vixhvajit/ster-vis-amr/sim/worlds/textures/floor.png

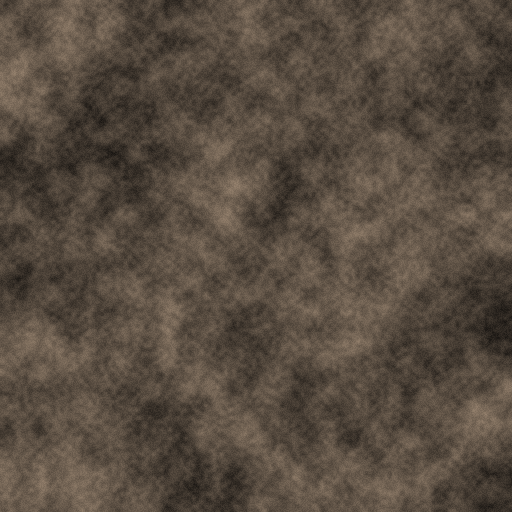
sim/worlds/textures/floor.png
