vixhvajit/ster-vis-amr/sim/worlds/textures/target_green.png

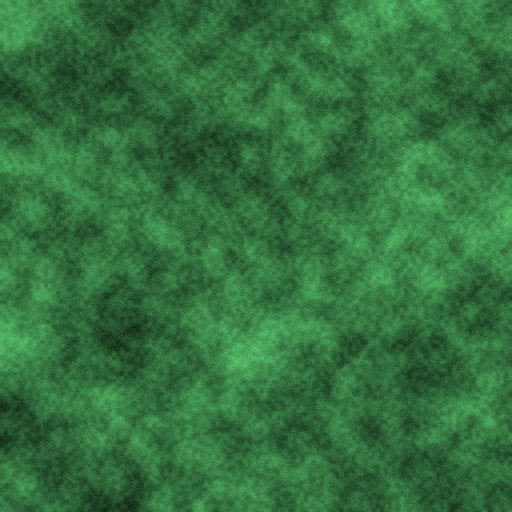
sim/worlds/textures/target_green.png
