vixhvajit/ster-vis-amr/sim/worlds/textures/target_red.png

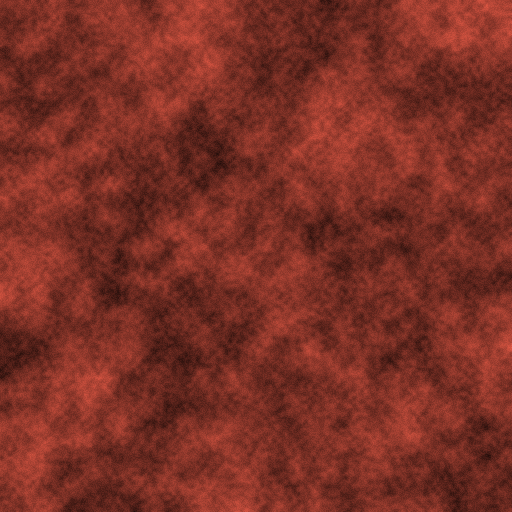
sim/worlds/textures/target_red.png
