vixhvajit/ster-vis-amr/sim/worlds/textures/target_yellow.png

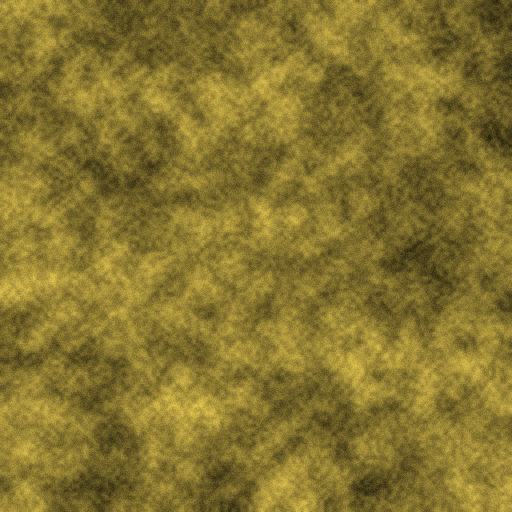
sim/worlds/textures/target_yellow.png
