vixhvajit/ster-vis-amr/sim/worlds/textures/wall.png

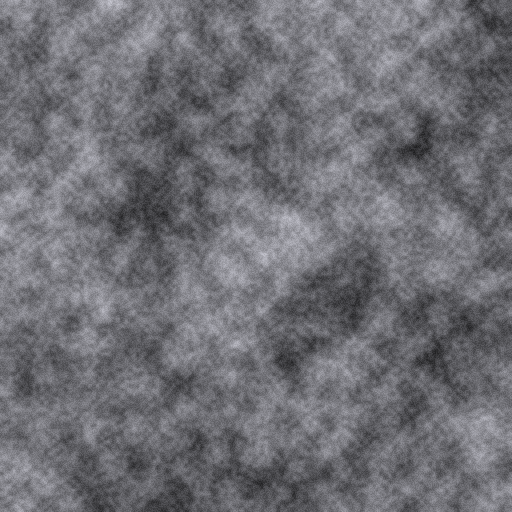
sim/worlds/textures/wall.png
