vixhvajit/ster-vis-amr/sim/models/ster_vis_test_amr/meshes/camera_clamps.stl

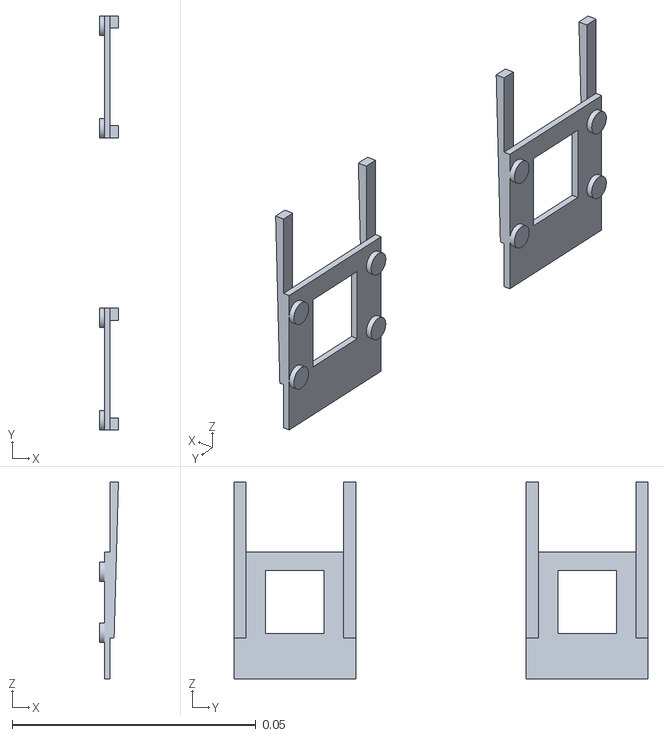
[picture p8: CAD file, 2026-09-25]
sim/models/ster_vis_test_amr/meshes/camera_clamps.stl
0.00389 x 0.085 x 0.0404
