vixhvajit/ster-vis-amr/sim/models/ster_vis_test_amr/meshes/deck.stl

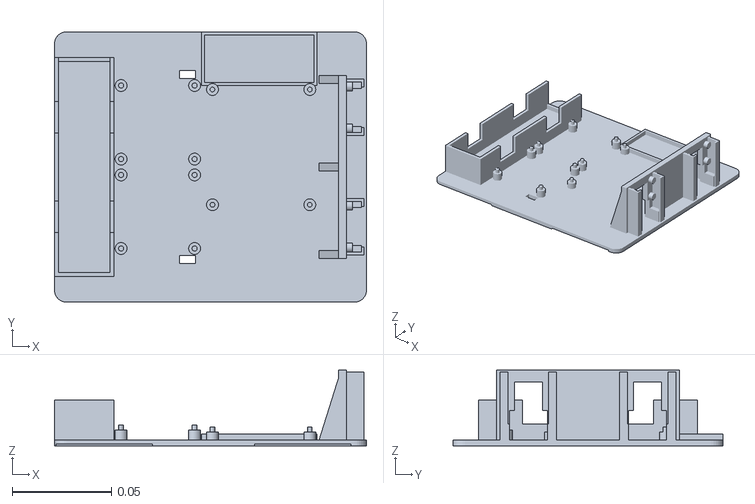
[picture p9: CAD file, 2026-09-25]
sim/models/ster_vis_test_amr/meshes/deck.stl
0.157 x 0.136 x 0.038
