vixhvajit/ster-vis-amr/sim/models/ster_vis_test_amr/model.sdf

<?xml version="1.0" ?>
<!-- GENERATED by build_model.py from the Ster-Vis hardware/test-amr CAD - edit
     that (or build_model.py), not this. Origin: on the floor under the centre
     of the wheelbase; x forward, y left, z up. -->
<sdf version="1.10">
  <model name="ster_vis_test_amr">
    <link name="base_link">
      <inertial><pose>-0.01576 0.00173 0.05458 0.00000 0.00000 0.00000</pose><mass>0.5266</mass><inertia><ixx>9.587e-04</ixx><ixy>-3.976e-05</ixy><ixz>7.668e-05</ixz><iyy>1.181e-03</iyy><iyz>-1.909e-06</iyz><izz>1.899e-03</izz></inertia></inertial>
      <collision name="c_deck"><pose>0.00350 0.00000 0.04445 0.00000 0.00000 0.00000</pose><geometry><box><size>0.15700 0.13600 0.00300</size></box></geometry></collision><collision name="c_motors_left"><pose>0.00000 0.05860 0.03210 0.00000 0.00000 0.00000</pose><geometry><box><size>0.14780 0.01880 0.02170</size></box></geometry></collision><collision name="c_motors_right"><pose>0.00000 -0.05860 0.03210 0.00000 0.00000 0.00000</pose><geometry><box><size>0.14780 0.01880 0.02170</size></box></geometry></collision><collision name="c_battery"><pose>-0.06000 0.00000 0.06295 0.00000 0.00000 0.00000</pose><geometry><box><size>0.03000 0.11000 0.03400</size></box></geometry></collision><collision name="c_boards"><pose>0.00600 -0.00100 0.06395 0.00000 0.00000 0.00000</pose><geometry><box><size>0.10200 0.08700 0.03600</size></box></geometry></collision><collision name="c_camera_bracket"><pose>0.07455 0.00000 0.06345 0.00000 0.00000 0.00000</pose><geometry><box><size>0.01310 0.09200 0.03500</size></box></geometry></collision>
      <visual name="deck"><pose>0.00000 0.00000 0.04295 0.00000 0.00000 0.00000</pose><geometry><mesh><uri>meshes/deck.stl</uri></mesh></geometry><material><ambient>0.62 0.63 0.66 1</ambient><diffuse>0.62 0.63 0.66 1</diffuse><specular>0.15 0.15 0.15 1</specular></material></visual><visual name="cam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
      <!-- The Ster-Vis stereo pair: two Camera Module 3, 60 mm apart. -->
      
      <sensor name="left_camera" type="camera">
        <pose>0.08160 0.03000 0.06970 0.00000 0.00000 0.00000</pose>
        <always_on>1</always_on>
        <update_rate>10</update_rate>
        <topic>/amr/stereo/left/image</topic>
        <camera name="left">
          <horizontal_fov>1.15192</horizontal_fov>
          <image><width>1280</width><height>720</height><format>R8G8B8</format></image>
          <clip><near>0.02</near><far>30</far></clip>
          <noise><type>gaussian</type><mean>0</mean><stddev>0.005</stddev></noise>
        </camera>
      </sensor>
      
      <sensor name="right_camera" type="camera">
        <pose>0.08160 -0.03000 0.06970 0.00000 0.00000 0.00000</pose>
        <always_on>1</always_on>
        <update_rate>10</update_rate>
        <topic>/amr/stereo/right/image</topic>
        <camera name="right">
          <horizontal_fov>1.15192</horizontal_fov>
          <image><width>1280</width><height>720</height><format>R8G8B8</format></image>
          <clip><near>0.02</near><far>30</far></clip>
          <noise><type>gaussian</type><mean>0</mean><stddev>0.005</stddev></noise>
        </camera>
      </sensor>
    </link>
    
    <link name="wheel_front_left">
      <pose>0.06200 0.08300 0.03250 -1.57080 0.00000 0.00000</pose>
      <inertial><mass>0.028</mass>
        <inertia><ixx>8.971e-06</ixx><iyy>8.971e-06</iyy><izz>1.479e-05</izz><ixy>0</ixy><ixz>0</ixz><iyz>0</iyz></inertia>
      </inertial>
      <collision name="collision">
        <geometry><cylinder><radius>0.03250</radius><length>0.02600</length></cylinder></geometry>
        <surface><friction><ode><mu>1.0</mu><mu2>1.0</mu2></ode></friction></surface>
      </collision>
      <visual name="tyre"><geometry><cylinder><radius>0.03250</radius><length>0.02600</length></cylinder></geometry><material><ambient>0.05 0.05 0.05 1</ambient><diffuse>0.05 0.05 0.05 1</diffuse><specular>0.15 0.15 0.15 1</specular></material></visual>
      <visual name="hub"><geometry><cylinder><radius>0.01788</radius><length>0.02700</length></cylinder></geometry><material><ambient>0.95 0.75 0.10 1</ambient><diffuse>0.95 0.75 0.10 1</diffuse><specular>0.15 0.15 0.15 1</specular></material></visual>
      <visual name="spoke"><geometry><box><size>0.03575 0.00585 0.02800</size></box></geometry><material><ambient>0.75 0.75 0.78 1</ambient><diffuse>0.75 0.75 0.78 1</diffuse><specular>0.15 0.15 0.15 1</specular></material></visual>
    </link>
    <joint name="wheel_front_left_joint" type="revolute">
      <parent>base_link</parent><child>wheel_front_left</child>
      <axis><xyz>0 0 1</xyz><limit><lower>-1e16</lower><upper>1e16</upper></limit>
        <dynamics><damping>0.0005</damping></dynamics></axis>
    </joint>
    <link name="wheel_front_right">
      <pose>0.06200 -0.08300 0.03250 -1.57080 0.00000 0.00000</pose>
      <inertial><mass>0.028</mass>
        <inertia><ixx>8.971e-06</ixx><iyy>8.971e-06</iyy><izz>1.479e-05</izz><ixy>0</ixy><ixz>0</ixz><iyz>0</iyz></inertia>
      </inertial>
      <collision name="collision">
        <geometry><cylinder><radius>0.03250</radius><length>0.02600</length></cylinder></geometry>
        <surface><friction><ode><mu>1.0</mu><mu2>1.0</mu2></ode></friction></surface>
      </collision>
      <visual name="tyre"><geometry><cylinder><radius>0.03250</radius><length>0.02600</length></cylinder></geometry><material><ambient>0.05 0.05 0.05 1</ambient><diffuse>0.05 0.05 0.05 1</diffuse><specular>0.15 0.15 0.15 1</specular></material></visual>
      <visual name="hub"><geometry><cylinder><radius>0.01788</radius><length>0.02700</length></cylinder></geometry><material><ambient>0.95 0.75 0.10 1</ambient><diffuse>0.95 0.75 0.10 1</diffuse><specular>0.15 0.15 0.15 1</specular></material></visual>
      <visual name="spoke"><geometry><box><size>0.03575 0.00585 0.02800</size></box></geometry><material><ambient>0.75 0.75 0.78 1</ambient><diffuse>0.75 0.75 0.78 1</diffuse><specular>0.15 0.15 0.15 1</specular></material></visual>
    </link>
    <joint name="wheel_front_right_joint" type="revolute">
      <parent>base_link</parent><child>wheel_front_right</child>
      <axis><xyz>0 0 1</xyz><limit><lower>-1e16</lower><upper>1e16</upper></limit>
        <dynamics><damping>0.0005</damping></dynamics></axis>
    </joint>
    <link name="wheel_rear_left">
      <pose>-0.06200 0.08300 0.03250 -1.57080 0.00000 0.00000</pose>
      <inertial><mass>0.028</mass>
        <inertia><ixx>8.971e-06</ixx><iyy>8.971e-06</iyy><izz>1.479e-05</izz><ixy>0</ixy><ixz>0</ixz><iyz>0</iyz></inertia>
      </inertial>
      <collision name="collision">
        <geometry><cylinder><radius>0.03250</radius><length>0.02600</length></cylinder></geometry>
        <surface><friction><ode><mu>1.0</mu><mu2>1.0</mu2></ode></friction></surface>
      </collision>
      <visual name="tyre"><geometry><cylinder><radius>0.03250</radius><length>0.02600</length></cylinder></geometry><material><ambient>0.05 0.05 0.05 1</ambient><diffuse>0.05 0.05 0.05 1</diffuse><specular>0.15 0.15 0.15 1</specular></material></visual>
      <visual name="hub"><geometry><cylinder><radius>0.01788</radius><length>0.02700</length></cylinder></geometry><material><ambient>0.95 0.75 0.10 1</ambient><diffuse>0.95 0.75 0.10 1</diffuse><specular>0.15 0.15 0.15 1</specular></material></visual>
      <visual name="spoke"><geometry><box><size>0.03575 0.00585 0.02800</size></box></geometry><material><ambient>0.75 0.75 0.78 1</ambient><diffuse>0.75 0.75 0.78 1</diffuse><specular>0.15 0.15 0.15 1</specular></material></visual>
    </link>
    <joint name="wheel_rear_left_joint" type="revolute">
      <parent>base_link</parent><child>wheel_rear_left</child>
      <axis><xyz>0 0 1</xyz><limit><lower>-1e16</lower><upper>1e16</upper></limit>
        <dynamics><damping>0.0005</damping></dynamics></axis>
    </joint>
    <link name="wheel_rear_right">
      <pose>-0.06200 -0.08300 0.03250 -1.57080 0.00000 0.00000</pose>
      <inertial><mass>0.028</mass>
        <inertia><ixx>8.971e-06</ixx><iyy>8.971e-06</iyy><izz>1.479e-05</izz><ixy>0</ixy><ixz>0</ixz><iyz>0</iyz></inertia>
      </inertial>
      <collision name="collision">
        <geometry><cylinder><radius>0.03250</radius><length>0.02600</length></cylinder></geometry>
        <surface><friction><ode><mu>1.0</mu><mu2>1.0</mu2></ode></friction></surface>
      </collision>
      <visual name="tyre"><geometry><cylinder><radius>0.03250</radius><length>0.02600</length></cylinder></geometry><material><ambient>0.05 0.05 0.05 1</ambient><diffuse>0.05 0.05 0.05 1</diffuse><specular>0.15 0.15 0.15 1</specular></material></visual>
      <visual name="hub"><geometry><cylinder><radius>0.01788</radius><length>0.02700</length></cylinder></geometry><material><ambient>0.95 0.75 0.10 1</ambient><diffuse>0.95 0.75 0.10 1</diffuse><specular>0.15 0.15 0.15 1</specular></material></visual>
      <visual name="spoke"><geometry><box><size>0.03575 0.00585 0.02800</size></box></geometry><material><ambient>0.75 0.75 0.78 1</ambient><diffuse>0.75 0.75 0.78 1</diffuse><specular>0.15 0.15 0.15 1</specular></material></visual>
    </link>
    <joint name="wheel_rear_right_joint" type="revolute">
      <parent>base_link</parent><child>wheel_rear_right</child>
      <axis><xyz>0 0 1</xyz><limit><lower>-1e16</lower><upper>1e16</upper></limit>
        <dynamics><damping>0.0005</damping></dynamics></axis>
    </joint>
    <!-- 4WD skid steer: both motors on a side run together, as each L298N
         drives one side. The odometry is perfect wheel odometry, which the
         real robot does not have (its BO motors have no encoders). -->
    <plugin filename="gz-sim-diff-drive-system" name="gz::sim::systems::DiffDrive">
      <left_joint>wheel_front_left_joint</left_joint><left_joint>wheel_rear_left_joint</left_joint>
      <right_joint>wheel_front_right_joint</right_joint><right_joint>wheel_rear_right_joint</right_joint>
      <wheel_separation>0.1660</wheel_separation>
      <wheel_radius>0.03250</wheel_radius>
      <max_linear_velocity>0.6</max_linear_velocity>
      <min_linear_velocity>-0.6</min_linear_velocity>
      <max_angular_velocity>3.0</max_angular_velocity>
      <min_angular_velocity>-3.0</min_angular_velocity>
      <max_linear_acceleration>1.0</max_linear_acceleration>
      <min_linear_acceleration>-1.0</min_linear_acceleration>
      <topic>/amr/cmd_vel</topic>
      <odom_topic>/amr/odometry</odom_topic>
      <tf_topic>/amr/tf</tf_topic>
      <frame_id>odom</frame_id>
      <child_frame_id>base_link</child_frame_id>
      <odom_publish_frequency>30</odom_publish_frequency>
    </plugin>
    <plugin filename="gz-sim-joint-state-publisher-system" name="gz::sim::systems::JointStatePublisher">
      <topic>/amr/joint_states</topic>
    </plugin>
  </model>
</sdf>
