vixhvajit/ster-vis-amr/(commit log)

2026-09-25 feat: controller for the Ster-Vis test AMR, and its Gazebo model
    The Raspberry Pi 5 software for the 3D-printed test robot: depth from the
    ster-vis service over HTTP, a scan built from it with Ster-Vis's
    laser_scan, reactive avoidance, and four BO motors on two L298Ns as a
    skid steer with a voltage cap on the PWM duty. The motors stop on stale
    depth, SIGTERM and exit. A systemd unit and an installer are included;
    the service is not enabled at boot.
    The scan is built from depth.npy rather than read from /api/v1/scan,
    because that JSON writes both "nothing in range" and "no depth" as null.
    sim/ holds a Gazebo Harmonic model built from the chassis CAD
    (hardware/test-amr on the Ster-Vis feat/t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
    [amr_arena.sdf, amr_test.sdf, bottom_deck.stl, camera_mount.stl, model.sdf, pillar.stl, spacer.stl, top_deck.stl]
2026-09-25 sim: model rebuilt from the screwless chassis
    The chassis now prints all its fasteners (Ster-Vis hardware/test-amr,
    commit 8b8c0e7). The model takes the printed parts from the assembled
    meshes chassis.py now exports, instead of undoing the print layout, so
    the wedges, pins, standoffs, clips and camera covers appear too. The
    stereo check is unchanged: 2.2 mm error at 0.867 m.
    [bottom_deck.stl, camera_mount.stl, fasteners.stl, model.sdf, pillar.stl, pillars.stl, spacer.stl, top_deck.stl]
2026-09-25 feat: minimal robot, and an avoider that remembers what it passed
    The test robot is now the minimal one (Ster-Vis hardware/test-amr
    bd416af): one printed deck, two L298Ns, the Bonka 3S 2200 mAh pack in a
    tray, and the lenses about 7 cm up instead of 12. Config defaults, the
    Ster-Vis scan band (-0.04..0.05) and the Gazebo model follow it.
    With the lower, narrower robot the avoider brushed obstacles in the
    Gazebo arena, always ones that had left the 66 degree view (or sat in
    Ster-Vis's blind left edge) before the robot had passed them. Fixes:
    - a short memory of obstacle points (8 s, within 1 m), carried along by
    dead reckoning on the commanded motion and replaced by the live scan
    wherev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
    [bottom_deck.stl, camera_clamps.stl, camera_mount.stl, deck.stl, fasteners.stl, model.sdf, pillars.stl, top_deck.stl]
